rafay-069/retro-controller-/BOM.csv

Item | Qty | Supplier | Cost/item | Total Cost | link
2.8" ILI9341 SPI TFT module with microSD slot (Robu R260027) | 1 | Robu.in | $8.85 | $8.85 | https://robu.in/product/ntl-28-inch-spi-touch-screen-module-tft-interface-240320-v12/
ESP32-S3-WROOM-1-N16R8 module | 1 | Robu.in | $6.47 | $6.47 | https://robu.in/product/espressif-esp32-s3-wroom-1-n16r8-module/
MAX98357A TQFN-16 chip | 1 | Robu.in | $2.94 | $2.94 | https://robu.in/product/max98357aetet-maxim-integrated-products/
TP4056 SOP-8 chip | 1 | Robu.in | $0.20 | $0.20 | https://robu.in/product/1-month-warranty-1253/
ME6211C33M5G SOT-23-5 | 1 | Robu.in | $0.20 | $0.20 | https://robu.in/product/me6211c33m5g-n-microne-500ma-fixed-3-3v-positive-electrode-6v-sot-23-5-voltage-regulators-linear-low-drop-out-ldo-regulators-rohs/
USBLC6-2SC6 SOT-23-6 | 1 | Robu.in | $0.20 | $0.20 | https://robu.in/product/usblc6-2sc6-ms-msksemi-4-5a-15v-150w-6v-5v-sot-23-6-esd-and-surge-protection-tvs-esd-rohs/
Tact switch 6x6 SMD TK-066 | 11 | Robu.in | $0.20 | $2.20 | https://robu.in/product/tact-switch-tk-066-4-pins-6x6-smd/
SanDisk Ultra 16GB microSD Class 10 | 1 | Robu.in | $16.69 | $16.69 | https://robu.in/product/sandisk-ultra-micro-sd-16gb-uhs-i-98mbs-r-class-10-memory-card/
Resistor 10k 0603 Yageo RC0603JR-0710KL | 2 | Robu.in | $0.20 | $0.40 | https://robu.in/product/rc0603jr-0710kl-yageo-res-10k-5-0-25w-0603-thick-film-pack-of-10/
Resistor 5.1k 0603 Yageo RC0603JR-075K1L | 2 | Robu.in | $0.20 | $0.40 | https://robu.in/product/rc0603jr-075k1l-yageo-res-thick-film-0603-5-1k-ohm-5-0-1w1-10w-%c2%b1100ppm-c-pad-smd-t-r/
Resistor 2k 0603 Yageo RC0603JR-072KL | 1 | Robu.in | $0.20 | $0.20 | https://robu.in/product/rc0603jr-072kl-yageo-res-thick-film-0603-2k-ohm-5-0-1w1-10w-%c2%b1100ppm-c-pad-smd-t-r/
Resistor 1k 0603 Yageo RC0603JR-071KL | 4 | Robu.in | $0.20 | $0.80 | https://robu.in/product/rc0603jr-071kl-yageo-res-thick-film-0603-1k-ohm-5-0-1w1-10w-%c2%b1100ppm-c-pad-smd-t-r/
Resistor 100k 0603 Yageo RC0603JR-07100KL | 2 | Robu.in | $0.20 | $0.40 | https://robu.in/product/rc0603jr-07100kl-yageo-res-thick-film-0603-100k-ohm-5-0-1w1-10w-%c2%b1100ppm-c-pad-smd-t-r/
Resistor 1M 0603 Yageo RC0603JR-071ML | 1 | Robu.in | $0.20 | $0.20 | https://robu.in/product/rc0603jr-071ml-yageo-res-thick-film-0603-1m-ohm-5-0-1w1-10w-%c2%b1100ppm-c-pad-smd-t-r/
Capacitor 1uF 0603 50V | 1 | Robu.in | $0.20 | $0.20 | https://robu.in/product/1uf-1000nf-50v-capacitor-0603-smd-package-pack-of-20/
Capacitor 10uF 0805 Taiyo Yuden TMK212BBJ106KGHT | 5 | Robu.in | $0.20 | $1.00 | https://robu.in/product/1-month-warranty-1335/
Capacitor 22uF 0805 Murata GRM21BR60J226ME39K | 1 | Robu.in | $0.20 | $0.20 | https://robu.in/product/grm21br60j226me39k-murata-electronics-6-3v-22uf-x5r-%c2%b120-0805-multilayer-ceramic-capacitors-mlcc-smd-smt-rohs/
Capacitor 100nF 0603 CCTC TCC0603X7R104K500CT | 3 | Robu.in | $0.20 | $0.60 | https://robu.in/product/tcc0603x7r104k500ct-cctc-smt-ceramic-capacitors-0603-x7r-104k100nf%c2%b110-rated-voltage50v-thickness0-80mm-tape/
LED red 0603 Lite-On LTST-C191KRKT | 2 | Robu.in | $0.20 | $0.40 | https://robu.in/product/ltst-c191krkt-lite-on-20ma-54mcd-water-clear-55%e2%84%8385%e2%84%83-631nm-red-130-75mw-2v-0603-led-indication-discrete-rohs/
LED green 0603 Xinglight XL-1608BGWC-06 | 1 | Robu.in | $0.20 | $0.20 | https://robu.in/product/xl-1608bgwc-06-xinglight-20ma-960mcd-green-lens-20%e2%84%8385%e2%84%83-positive-stick-blue-120-70mw-3-3v-0603-led-indication-discrete-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
SS14 SMA diode MDD | 1 | Robu.in | $0.20 | $0.20 | https://robu.in/product/ss14-mdd-40v-independent-1a-550mv1a-smado-214ac-schottky-diodes-rohs/
Slide switch SS-12D10 (SS-12D10L10 listing) | 1 | Robu.in | $0.20 | $0.20 | https://robu.in/product/1-month-warranty-691/
M3 screws EasyMech bolt + nut set 25 pcs | 1 | Robu.in | $0.76 | $0.76 | https://robu.in/product/easymech-m3-x-6mm-chhd-bolt-nut-and-washer-set-25-pcs/
Speaker 40mm 8 ohm 0.5W | 1 | Robocraze | $0.61 | $0.61 | https://robocraze.com/products/8-ohm-0-25w-speaker
USB-C 16-pin SMD female SHOUHAN 336-TYPE-C-16P | 1 | Evelta | $0.20 | $0.20 | https://evelta.com/usb-3-1-type-c-smd-16-position-female-receptacle-connector/
Estimated total shipping | 1 |  |  | $0.00
