rafay-069/retro-controller-/shell_back.stl

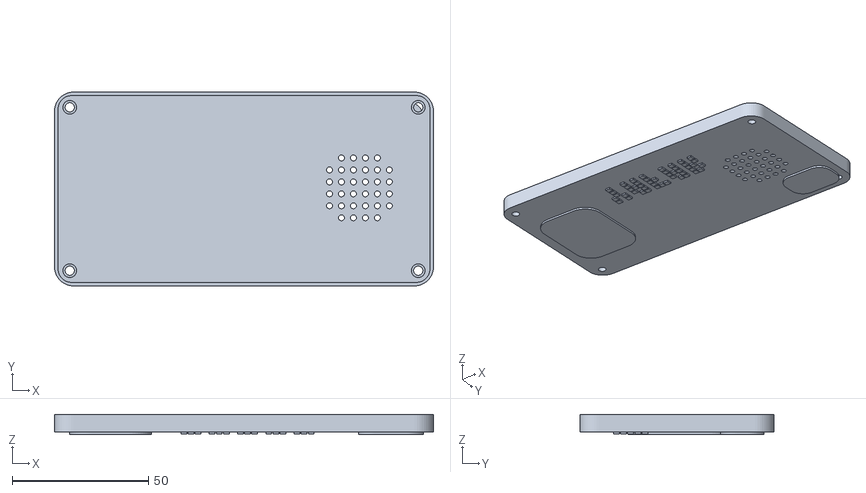
[picture p1: CAD file, 2026-11-08]
shell_back.stl
139.2 x 71.2 x 7.40
