rafay-069/retro-controller-/caps.stl

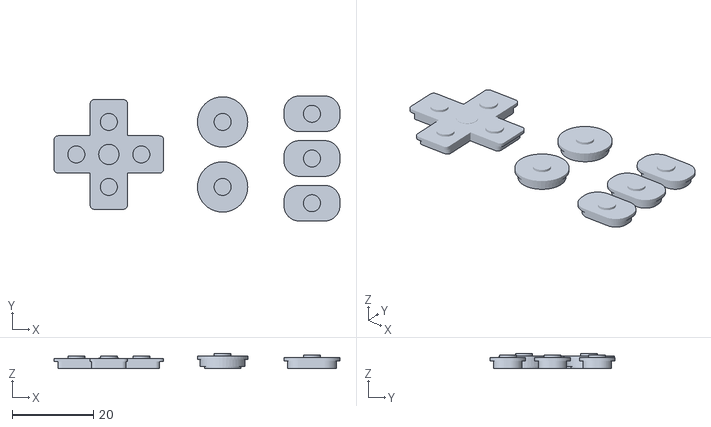
[picture p2: CAD file, 2026-11-08]
caps.stl
70.4 x 30.8 x 3.65
