rafay-069/retro-controller-/shell_front.stl

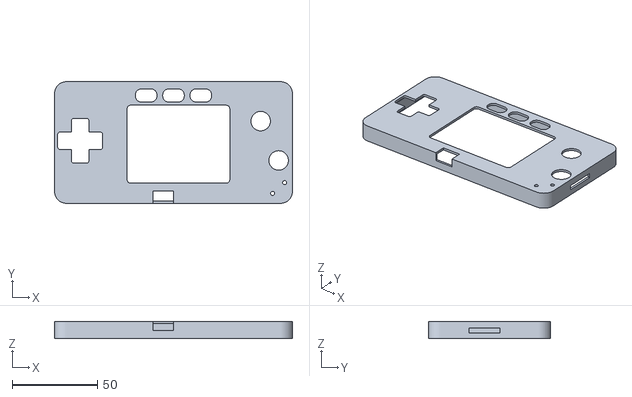
[picture p3: CAD file, 2026-11-08]
shell_front.stl
139.2 x 71.2 x 10.1
