rafay-069/retro-controller-/retro_console.kicad_pcb

## KiCad design retro_console.kicad_pcb (2026-11-09)

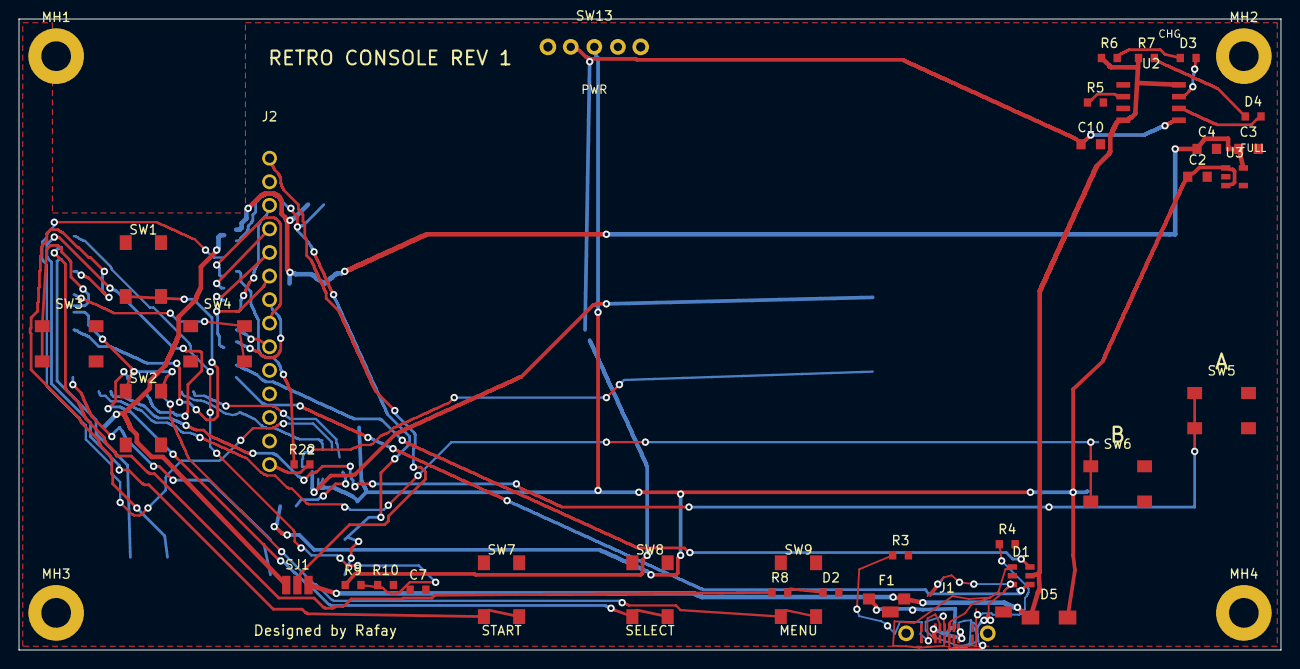
[picture p4: board retro_console.kicad_pcb from above]

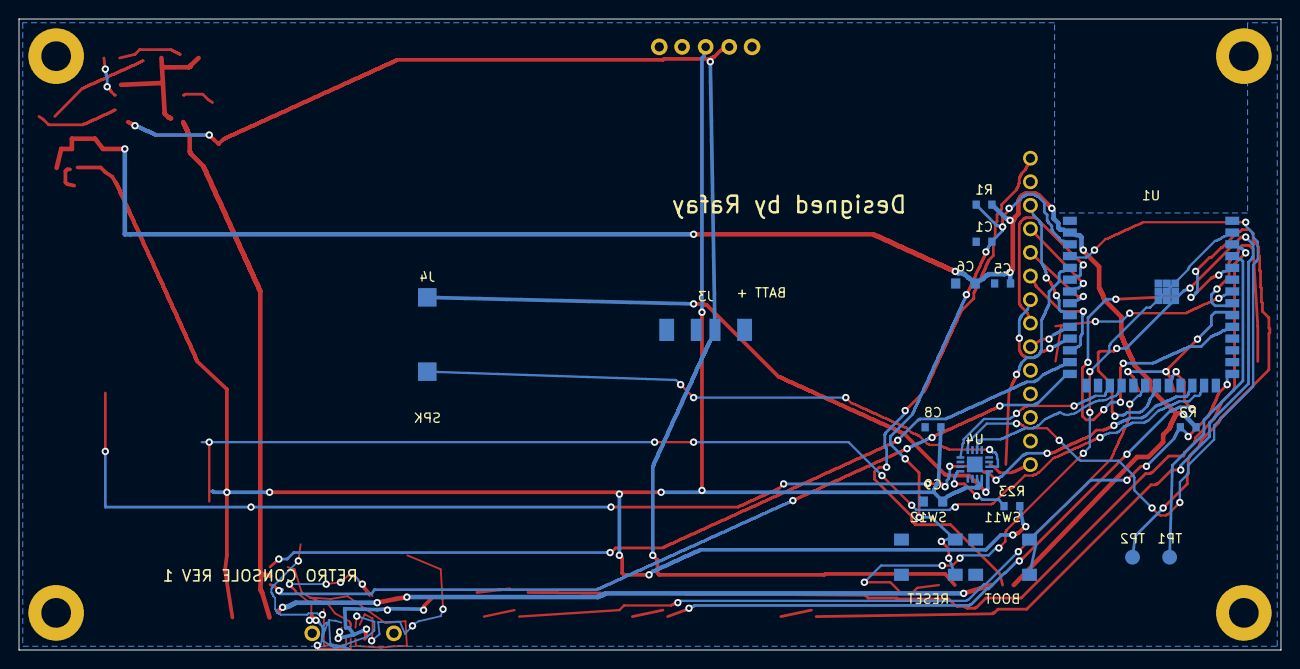
[picture p5: board retro_console.kicad_pcb from below]

Board: 3 copper layers, 136.0 x 68.0 mm, 55 parts (16 on the bottom side), 51 nets.

Parts:
C1: C1U; C1
C2: C10U; C2
C3: C10U; C3
C4: C22U; C4
C5: C100N; C5
C6: C10U; C6
C7: C100N; C7
C8: C100N; C8
C9: C10U; C9
C10: C10U; C10
D1: USBLC6-2SC6; D1
D2: LED_RED; D2
D3: LED_RED; D3
D4: LED_GRN; D4
D5: SS14; D5
F1: PTC1A1; F1
J1: USB_C_16P; J1
J2: SCR_1x14; J2
J3: B2B-PH-SM4-TB; J3
J4: SPK_PADS; J4
MH1: M3; MH1
MH2: M3; MH2
MH3: M3; MH3
MH4: M3; MH4
R1: R10K; R1
R2: R10K; R2
R3: R5K1; R3
R4: R5K1; R4
R5: R2K; R5
R6: R1K; R6
R7: R1K; R7
R8: R1K; R8
R9: R100K; R9
R10: R100K; R10
R22: R1K; R22
R23: R1M; R23
SJ1: JUMPER3; SJ1
SW1: TACT6x6; SW1
SW2: TACT6x6; SW2
SW3: TACT6x6; SW3
SW4: TACT6x6; SW4
SW5: TACT6x6; SW5
SW6: TACT6x6; SW6
SW7: TACT6x6; SW7
SW8: TACT6x6; SW8
SW9: TACT6x6; SW9
SW11: TACT6x6; SW11
SW12: TACT6x6; SW12
SW13: SS-12D10; SW13
TP1: TP; TP1
TP2: TP; TP2
U1: ESP32-S3-WROOM-1-N16R8; U1
U2: TP4056; U2
U3: ME6211C33; U3
U4: MAX98357A; U4

Connections:
+3V3: C3.1, C4.1, C5.1, C6.1, R1.1, R2.1, SJ1.1, U1.2, U3.5
+BATT: C10.1, J3.1, R9.1, SW13.1, U2.5
AMP_SD: R23.2, U4.4
BATT_ADC: C7.1, R9.2, R10.1, U1.39
BOOT: R2.2, SW11.1, SW11.2, U1.27
BTN_A: SW5.1, SW5.2, U1.24
BTN_B: SW6.1, SW6.2, U1.25
BTN_DOWN: SW2.1, SW2.2, U1.32
BTN_LEFT: SW3.1, SW3.2, U1.33
BTN_MENU: SW9.1, SW9.2, U1.20
BTN_RIGHT: SW4.1, SW4.2, U1.34
BTN_SELECT: SW8.1, SW8.2, U1.22
BTN_START: SW7.1, SW7.2, U1.21
BTN_UP: SW1.1, SW1.2, U1.31
CC1: J1.A5, R3.1
CC2: J1.B5, R4.1
CHRG: D3.2, U2.7
EN: C1.1, R1.2, SW12.1, SW12.2, U1.3
GND: C1.2, C2.2, C3.2, C4.2, C5.2, C6.2, C7.2, C8.2, C9.2, C10.2, D1.2, D2.2, J1.A1, J1.A12, J1.B1, J1.B12, J1.S1, J1.S2, J1.S3, J1.S4, J2.2, J3.2, R3.2, R4.2, R5.2, R10.2, SW1.3, SW1.4, SW2.3, SW2.4, SW3.3, SW3.4, SW4.3, SW4.4, SW5.3, SW5.4, SW6.3, SW6.4, SW7.3, SW7.4, SW8.3, SW8.4, SW9.3, SW9.4, SW11.3, SW11.4, SW12.3, SW12.4, U1.1, U1.40, U1.41, U2.1, U2.3, U3.2, U4.2, U4.3, U4.11, U4.15, U4.17
I2S_BCK: U1.4, U4.16
I2S_DOUT: U1.17, U4.1
I2S_WS: U1.18, U4.14
LCD_BL: J2.8, U1.6
LCD_CS: J2.3, U1.9
LCD_DC: J2.5, U1.8
LCD_RST: J2.4, U1.7
LCD_VCC: J2.1, SJ1.2
LED2_A: D3.1, R6.2
LED3_A: D4.1, R7.2
LED_A: D2.1, R8.2
LED_STAT: R8.1, U1.38
MECH: J3.3, J3.4, MH1.1, MH2.1, MH3.1, MH4.1, SW13.4, SW13.5
NC_MAX: U4.5, U4.6, U4.12, U4.13
PROG: R5.1, U2.2
RXD0: TP2.1, U1.36
SD_CS: R22.1, U1.5
SD_CS_M: J2.14, R22.2
SPI_MISO: J2.9, U1.10
SPI_MOSI: J2.6, U1.12
SPI_SCK: J2.7, U1.11
SPK_N: J4.2, U4.10
SPK_P: J4.1, U4.9
STDBY: D4.2, U2.6
TXD0: TP1.1, U1.37
USB_DM: D1.6, U1.13
USB_DM_C: D1.1, J1.A7, J1.B7
USB_DP: D1.4, U1.14
USB_DP_C: D1.3, J1.A6, J1.B6
VBUS: D1.5, D5.1, F1.2, R6.1, R7.1, SJ1.3, U2.4, U2.8
VBUS_IN: F1.1, J1.A4, J1.A9, J1.B4, J1.B9
VSYS: C2.1, C8.1, C9.1, D5.2, R23.1, SW13.2, U3.1, U3.3, U4.7, U4.8
