rafay-069/retro-controller-/JOURNAL.md

# rafay game controller: devlog

<!-- Generated by Half Life from project wkee5b2u9xixtaoo3o2pxofn. Edits here are overwritten on the next sync. -->
<!-- Generated: 1970-01-01T00:00:00.000Z -->

> [!NOTE]
> This devlog is mirrored from [Half Life](https://halflife.hackclub.com) ([open the project](https://halflife.hackclub.com/projects/wkee5b2u9xixtaoo3o2pxofn)). Editing it here will not change the platform's copy, and the next sync overwrites this file.

> soo this is going to be a game controller in retro style and we can play most of the emulators games in thik like mario pokemon and other too

| Week | Tier | Hours logged | Entries |
| --- | --- | --- | --- |
| Week 5 | Tier 2 | 0h | 0 |

_No entries logged yet._
